arnaldojr/coracao_led/README.md

coracao_led
===========

desenvolvimento de um placa no formato de um coração rodeado de Led.

Microcontrolado por um pic18f452;
Acelerometro adxl345 para detecção de movimentos;
Conversor DC/DC step-Up 3v/5v para alimentação por pilha;
Saida serial para PC;
