arnaldojr/coracao_led/Lista de material e imagens/Documento1.pdf

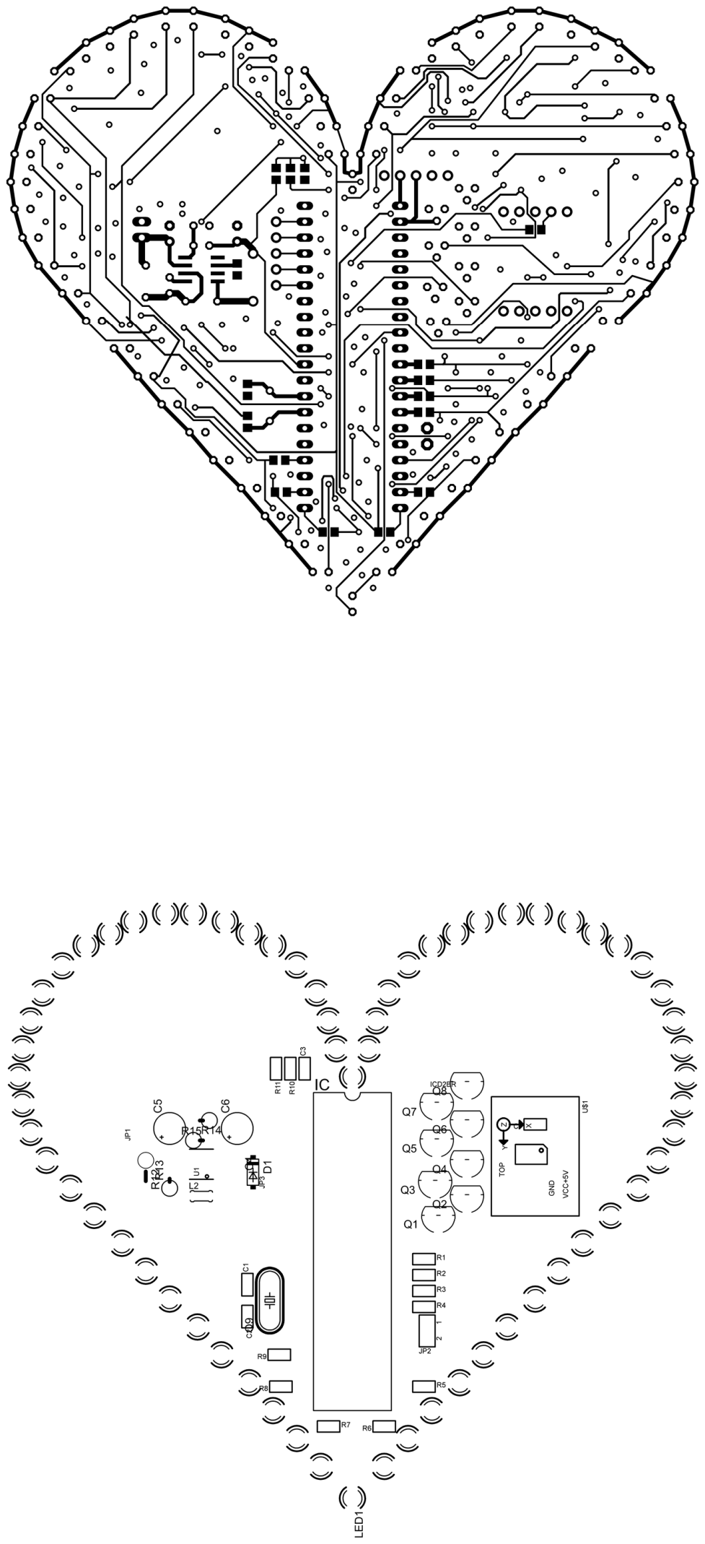
[picture p1: page 1]
