arnaldojr/coracao_led/Lista de material e imagens/Sem título.png

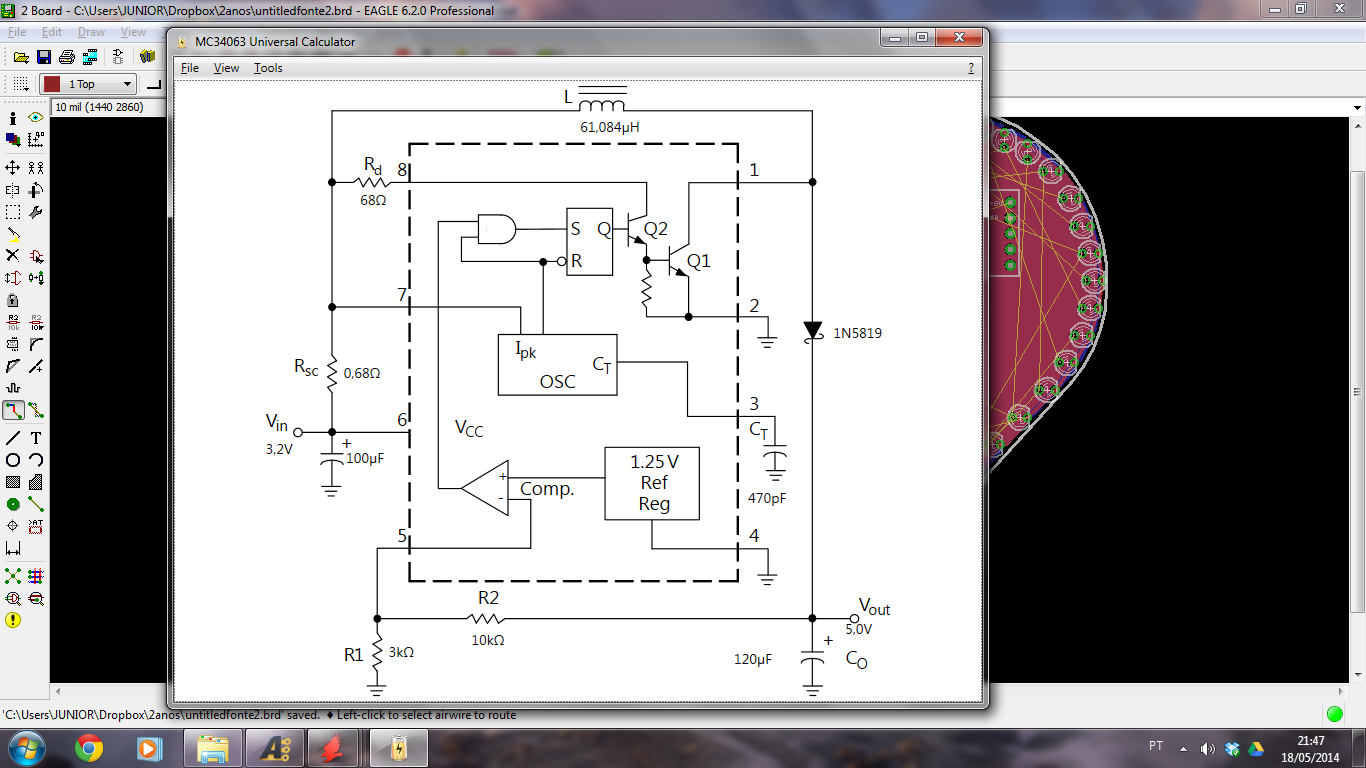
Lista de material e imagens/Sem título.png
