arnaldojr/coracao_led/Lista de material e imagens/untitledfonte2.pdf

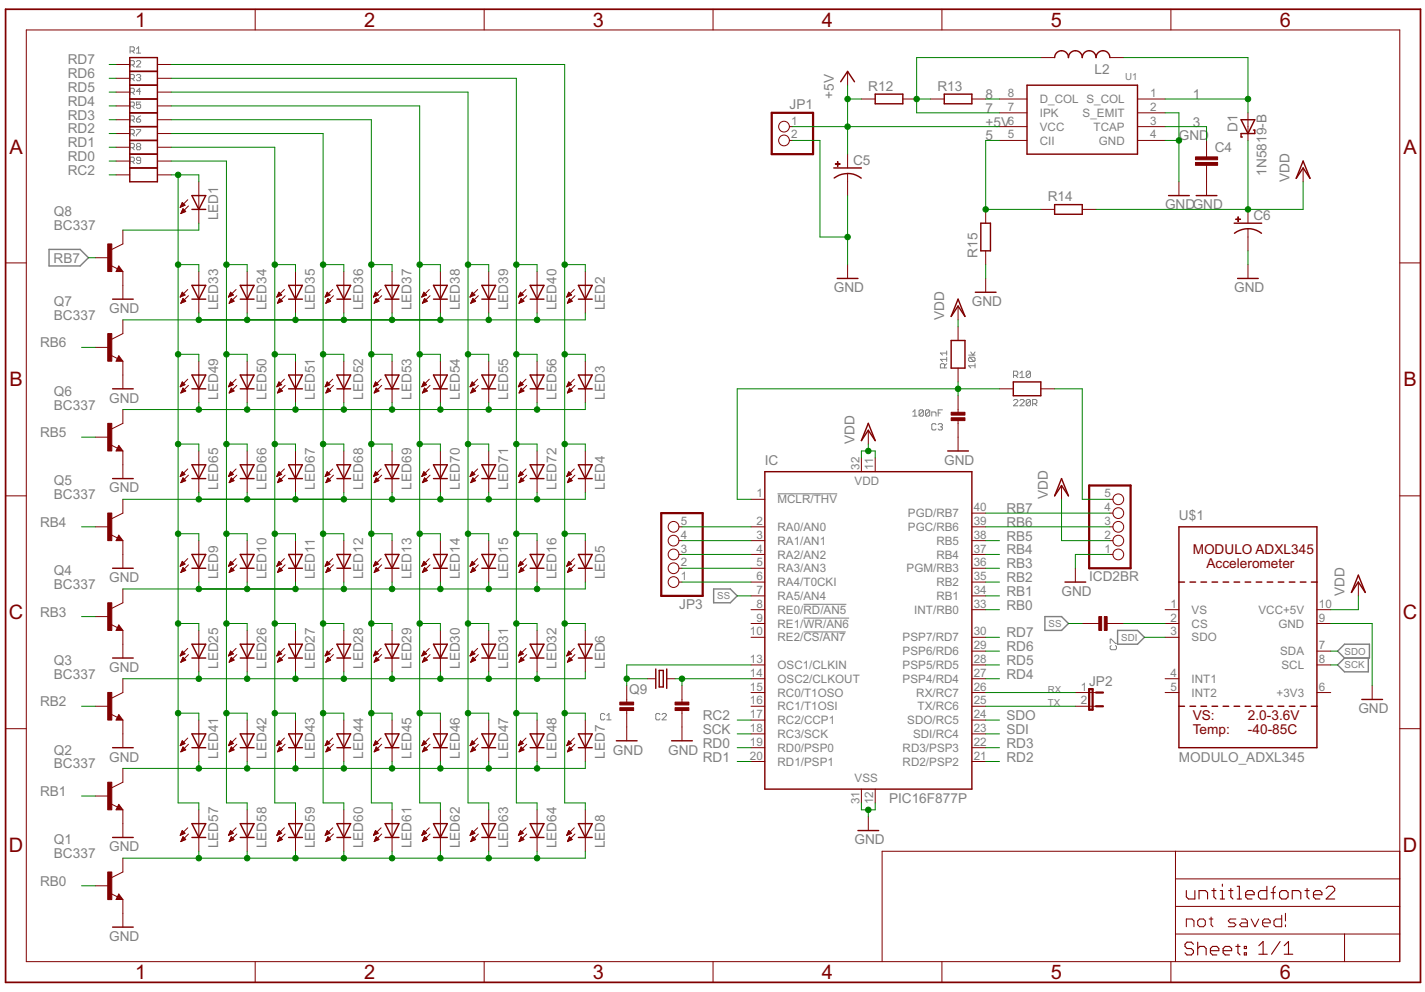
[picture p3: page 1]
