arnaldojr/coracao_led/Hardware/untitledfonte2.brd

## EAGLE design Hardware/untitledfonte2.brd (2014-07-24)

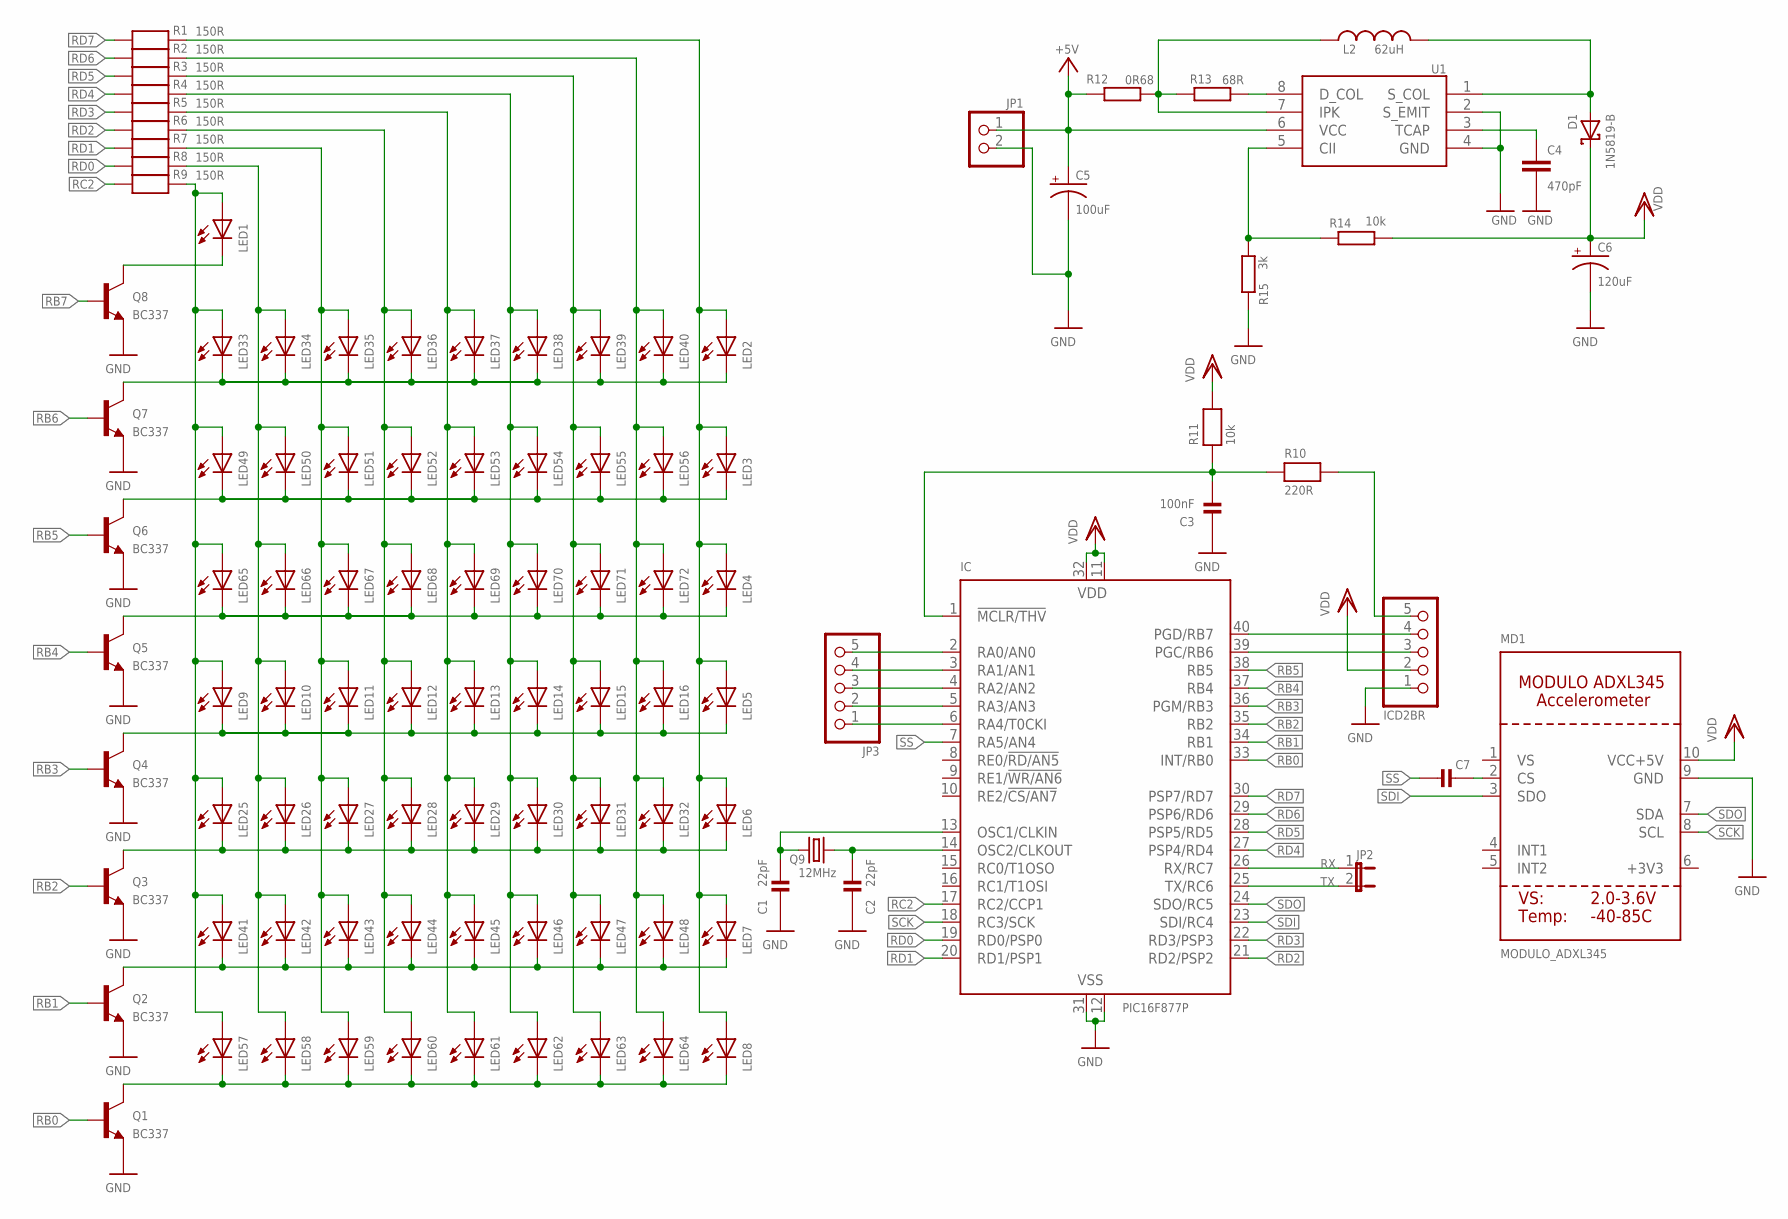
[picture p4: schematic untitledfonte2.sch]

Parts:
C1, C2: 22pF; 0805_NOTHERMALS
C3: 100nF; 0805_NOTHERMALS
C4: 470pF; C0805
C5: 100uF; E2,5-5
C6: 120uF; E2,5-5
C7: CAP_CERAMIC0805-NOTHERMALS; 0805_NOTHERMALS
D1: 1N5819-B; DO41-7.6
IC: PIC16F877P; DIL40
ICD2BR: HEADER-1X5ROUND; 1X05_ROUND
JP1: HEADER-1X2; 1X02_OVAL
JP2: JUMPER2
JP3: HEADER-1X5ROUND; 1X05_ROUND
L2: 62uH; 0204/5
LED1, LED2, LED3, LED4, LED5, LED6, LED7, LED8, LED9, LED10, LED11, LED12, LED13, LED14, LED15, LED16, LED25, LED26, LED27, LED28, LED29, LED30, LED31, LED32, LED33, LED34, LED35, LED36, LED37, LED38, LED39, LED40, LED41, LED42, LED43, LED44, LED45, LED46, LED47, LED48, LED49, LED50, LED51, LED52, LED53, LED54, LED55, LED56, LED57, LED58, LED59, LED60, LED61, LED62, LED63, LED64, LED65, LED66, LED67, LED68, LED69, LED70, LED71, LED72: LED3MM
MD1: MODULO_ADXL345
Q1, Q2, Q3, Q4, Q5, Q6, Q7, Q8: BC337; TO92
Q9: 12MHz; HC49/S
R1, R2, R3, R4, R5, R6, R7, R8, R9: 150R; 0805_NOTHERMALS
R10: 220R; 0805_NOTHERMALS
R11: 10k; 0805_NOTHERMALS
R12: 0R68; 0207/5V
R13: 68R; 0207/2V
R14: 10k; 0207/2V
R15: 3k; 0207/2V
U1: MC34063A; SOIC8_150MIL

Connections:
1: D1.A, L2.2, U1.1 (S_COL)
3: C4.1, U1.3 (TCAP)
5: R14.1, R15.2, U1.5 (CII)
7: L2.1, R12.2, R13.1, U1.7 (IPK)
8: R13.2, U1.8 (D_COL)
+5V: C5.+, JP1.1, R12.1, U1.6 (VCC)
GND: C1.1, C2.1, C3.1, C4.2, C5.-, C6.-, IC.12 (VSS), IC.31 (VSS), ICD2BR.1, JP1.2, MD1.9 (GND), Q1.1 (E), Q2.1 (E), Q3.1 (E), Q4.1 (E), Q5.1 (E), Q6.1 (E), Q7.1 (E), Q8.1 (E), R15.1, U1.2 (S_EMIT), U1.4 (GND)
unnamed: LED1.K (C), Q8.3 (C)
unnamed: C7.1, MD1.2 (CS)
unnamed: LED4.K (C), LED65.K (C), LED66.K (C), LED67.K (C), LED68.K (C), LED69.K (C), LED70.K (C), LED71.K (C), LED72.K (C), Q5.3 (C)
unnamed: LED3.K (C), LED49.K (C), LED50.K (C), LED51.K (C), LED52.K (C), LED53.K (C), LED54.K (C), LED55.K (C), LED56.K (C), Q6.3 (C)
unnamed: LED8.K (C), LED57.K (C), LED58.K (C), LED59.K (C), LED60.K (C), LED61.K (C), LED62.K (C), LED63.K (C), LED64.K (C), Q1.3 (C)
unnamed: LED7.K (C), LED41.K (C), LED42.K (C), LED43.K (C), LED44.K (C), LED45.K (C), LED46.K (C), LED47.K (C), LED48.K (C), Q2.3 (C)
unnamed: LED1.A, LED9.A, LED25.A, LED33.A, LED41.A, LED49.A, LED57.A, LED65.A, R9.2
unnamed: LED10.A, LED26.A, LED34.A, LED42.A, LED50.A, LED58.A, LED66.A, R8.2
unnamed: LED11.A, LED27.A, LED35.A, LED43.A, LED51.A, LED59.A, LED67.A, R7.2
unnamed: LED12.A, LED28.A, LED36.A, LED44.A, LED52.A, LED60.A, LED68.A, R6.2
unnamed: LED2.K (C), LED33.K (C), LED34.K (C), LED35.K (C), LED36.K (C), LED37.K (C), LED38.K (C), LED39.K (C), LED40.K (C), Q7.3 (C)
unnamed: LED13.A, LED29.A, LED37.A, LED45.A, LED53.A, LED61.A, LED69.A, R5.2
unnamed: LED14.A, LED30.A, LED38.A, LED46.A, LED54.A, LED62.A, LED70.A, R4.2
unnamed: LED5.K (C), LED9.K (C), LED10.K (C), LED11.K (C), LED12.K (C), LED13.K (C), LED14.K (C), LED15.K (C), LED16.K (C), Q4.3 (C)
unnamed: LED15.A, LED31.A, LED39.A, LED47.A, LED55.A, LED63.A, LED71.A, R3.2
unnamed: LED16.A, LED32.A, LED40.A, LED48.A, LED56.A, LED64.A, LED72.A, R2.2
unnamed: LED2.A, LED3.A, LED4.A, LED5.A, LED6.A, LED7.A, LED8.A, R1.2
unnamed: IC.2 (RA0/AN0), JP3.5
unnamed: IC.3 (RA1/AN1), JP3.4
unnamed: IC.4 (RA2/AN2), JP3.3
unnamed: IC.5 (RA3/AN3), JP3.2
unnamed: IC.6 (RA4/T0CKI), JP3.1
unnamed: LED6.K (C), LED25.K (C), LED26.K (C), LED27.K (C), LED28.K (C), LED29.K (C), LED30.K (C), LED31.K (C), LED32.K (C), Q3.3 (C)
unnamed: C1.2, IC.13 (OSC1/CLKIN), Q9.2
unnamed: C2.2, IC.14 (OSC2/CLKOUT), Q9.1
unnamed: ICD2BR.5, R10.2
unnamed: C3.2, IC.1 (!MCLR/THV), R10.1, R11.1
RB0: IC.33 (INT/RB0), Q1.2 (B)
RB1: IC.34 (RB1), Q2.2 (B)
RB2: IC.35 (RB2), Q3.2 (B)
RB3: IC.36 (PGM/RB3), Q4.2 (B)
RB4: IC.37 (RB4), Q5.2 (B)
RB5: IC.38 (RB5), Q6.2 (B)
RB6: IC.39 (PGC/RB6), ICD2BR.3, Q7.2 (B)
RB7: IC.40 (PGD/RB7), ICD2BR.4, Q8.2 (B)
RC2: IC.17 (RC2/CCP1), R9.1
RD0: IC.19 (RD0/PSP0), R8.1
RD1: IC.20 (RD1/PSP1), R7.1
RD2: IC.21 (RD2/PSP2), R6.1
RD3: IC.22 (RD3/PSP3), R5.1
RD4: IC.27 (PSP4/RD4), R4.1
RD5: IC.28 (PSP5/RD5), R3.1
RD6: IC.29 (PSP6/RD6), R2.1
RD7: IC.30 (PSP7/RD7), R1.1
RX: IC.26 (RX/RC7), JP2.1
SCK: IC.18 (RC3/SCK), MD1.8 (SCL)
SDI: IC.23 (SDI/RC4), MD1.3 (SDO)
SDO: IC.24 (SDO/RC5), MD1.7 (SDA)
SS: C7.2, IC.7 (RA5/AN4)
TX: IC.25 (TX/RC6), JP2.2
VDD: C6.+, D1.C, IC.11 (VDD), IC.32 (VDD), ICD2BR.2, MD1.10 (VCC+5V), R11.2, R14.2

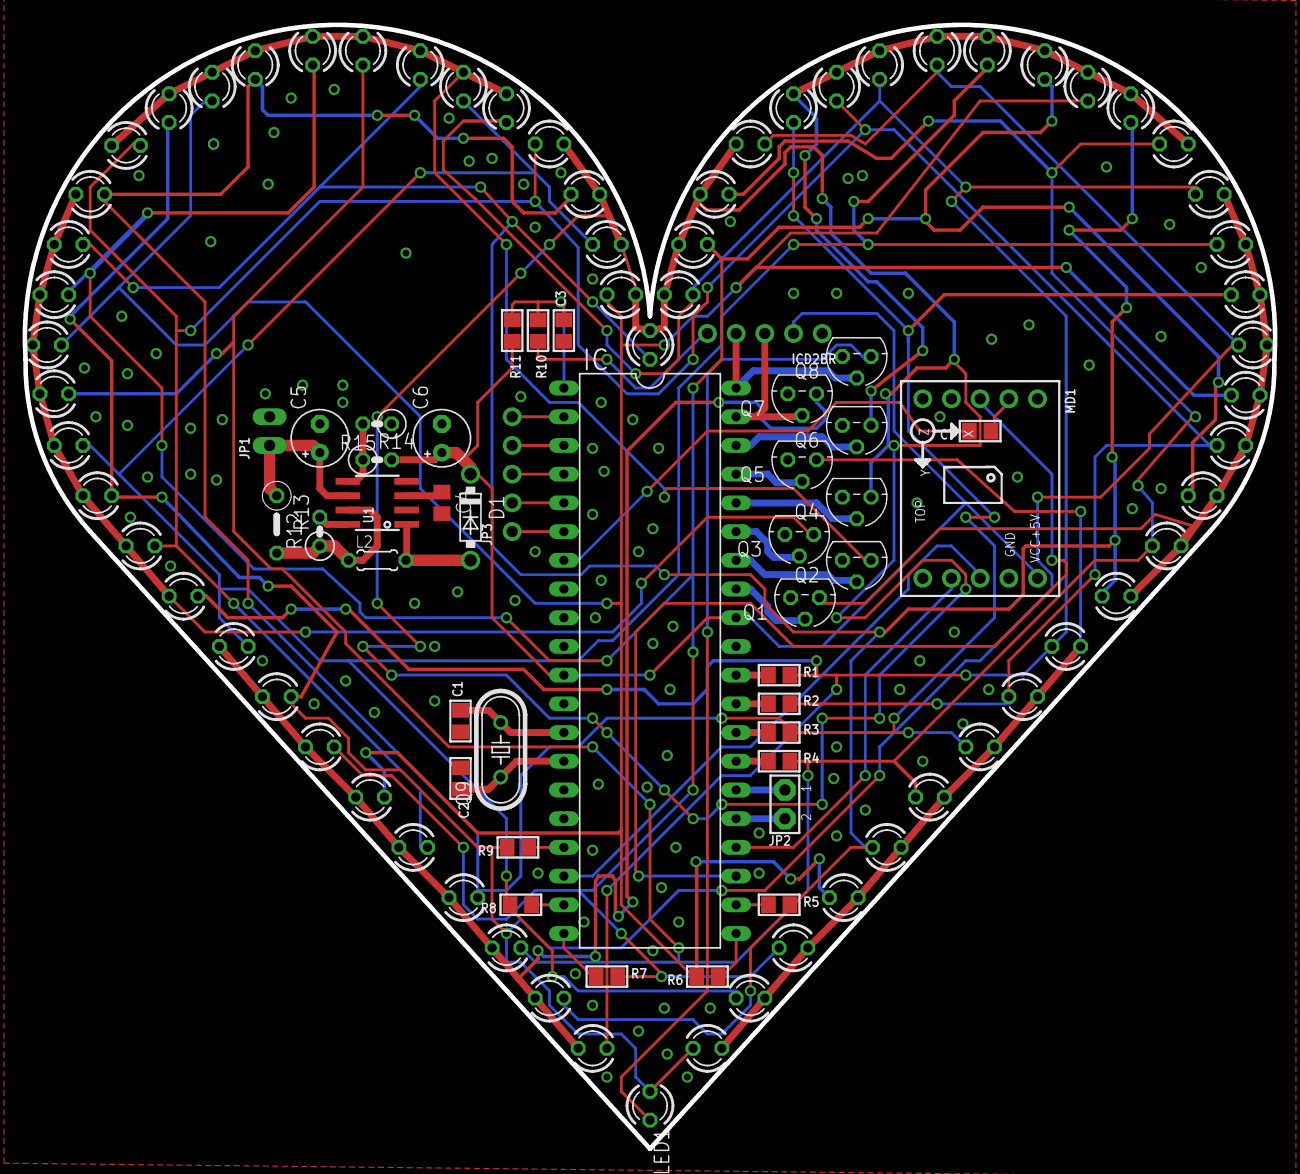
[picture p5: board untitledfonte2.brd from above]

Board: 2 copper layers, 110.6 x 99.4 mm, 104 parts (0 on the bottom side), 58 nets.
