arnaldojr/coracao_led/Sofware/main.c

/* Nome: main.c
 * Projeto: Coração LED
 * Autor: Arnaldo Jr
 * Data de Criação: 26/07/2014
 */

#include <p18f452.h>
#include <delays.h>
#include <stdlib.h>
#include "leds.h"

#pragma config WDT = OFF, LVP = OFF, OSC = XT, PWRT = ON, BOR = ON, BORV = 42

//PROTOTIPO DE FUNÇOES



void main()
{
 	//CONFIGURAÇAO DOS PORTS
	TRISA = 0x00; 		// RA0 ATÉ RA5 COMO SAIDA
	TRISB = 0x00;		// RB0 ATÉ RB7 COMO SAIDA ACIONA TRANSISTORES
	TRISC = 0b10000000; // RC7: Rx e RC6:Tx RC2-SAIDA LED
	TRISD = 0x00;		// RD0 ATÉ RD7 COMO SAIDA PARA OS LEDS 
	TRISE = 0x00;		// RE0 ATÉ RE2 COMO SAIDA
	

	while(1)
	{
/*		int i;
		for (i=0;i<N_LEDS;i++)	//giro no sentido anti-horario acende um por vez
		{
			acender_led(i,vled);
			Delay10KTCYx(250);		// 250ms
		}
		
		for (i=N_LEDS;i=0;i--)		//giro no sentido horario acende um por vez
			{
			acender_led(i,vled);
			Delay1KTCYx(250);		// 250ms
		}		
*/
		
/*		Delay1KTCYx(250);	//Delay  250 * 1000 * 1 = 250000 µs  = 0,25s = 250ms @ 4MHz
		if(PORTB==0b10000000)
		{
			PORTB=0b00000001;
			PORTD = PORTD<<1;
		}
		else PORTB = PORTB<< 1;
		
		if(PORTD==0b10000000)
		PORTD = 0b00000001;
			
*/	
PORTB=0b10000000; PORTD=0b00000000; PORTC=0b00000100; Delay10KTCYx(250);		//LED1
                                                      
PORTB=0b00010000; PORTD=0b00000000; PORTC=0b00000100; Delay10KTCYx(250);		//LED2
PORTB=0b00010000; PORTD=0b00000001; PORTC=0b00000000; Delay10KTCYx(250);		//LED3
PORTB=0b00010000; PORTD=0b00000010; PORTC=0b00000000; Delay10KTCYx(250);		//LED4
PORTB=0b00010000; PORTD=0b00000100; PORTC=0b00000000; Delay10KTCYx(250);		//LED5								
PORTB=0b00010000; PORTD=0b00001000; PORTC=0b00000000; Delay10KTCYx(250);		//LED6
PORTB=0b00010000; PORTD=0b00010000; PORTC=0b00000000; Delay10KTCYx(250);		//LED7
PORTB=0b00010000; PORTD=0b00100000; PORTC=0b00000000; Delay10KTCYx(250);		//LED8
PORTB=0b00010000; PORTD=0b01000000; PORTC=0b00000000; Delay10KTCYx(250);		//LED9									
PORTB=0b00010000; PORTD=0b10000000; PORTC=0b00000000; Delay10KTCYx(250);		//LED10 ok
                                                      
PORTB=0b00000001; PORTD=0b00001000; PORTC=0b00000000; Delay10KTCYx(250);		//LED11								
PORTB=0b00000001; PORTD=0b00010000; PORTC=0b00000000; Delay10KTCYx(250);		//LED12
PORTB=0b00000001; PORTD=0b00000001; PORTC=0b00000000; Delay10KTCYx(250);		//LED13
PORTB=0b00000001; PORTD=0b01000000; PORTC=0b00000000; Delay10KTCYx(250);		//LED14
PORTB=0b00000001; PORTD=0b00000100; PORTC=0b00000000; Delay10KTCYx(250);		//LED15
PORTB=0b00000001; PORTD=0b00000000; PORTC=0b00000100; Delay10KTCYx(250);		//LED16
PORTB=0b00000001; PORTD=0b00100000; PORTC=0b00000000; Delay10KTCYx(250);		//LED17									
PORTB=0b00000001; PORTD=0b00000001; PORTC=0b00000000; Delay10KTCYx(250);		//LED18
PORTB=0b00000001; PORTD=0b10000000; PORTC=0b00000000; Delay10KTCYx(250);		//LED19 ok
                                                      
PORTB=0b00100000; PORTD=0b00010000; PORTC=0b00000000; Delay10KTCYx(250);		//LED20
PORTB=0b00100000; PORTD=0b00001000; PORTC=0b00000000; Delay10KTCYx(250);		//LED21
PORTB=0b00100000; PORTD=0b00000100; PORTC=0b00000000; Delay10KTCYx(250);		//LED22
PORTB=0b00100000; PORTD=0b00000010; PORTC=0b00000000; Delay10KTCYx(250);		//LED23								
PORTB=0b00100000; PORTD=0b00000001; PORTC=0b00000000; Delay10KTCYx(250);		//LED24
PORTB=0b00100000; PORTD=0b00000000; PORTC=0b00000100; Delay10KTCYx(250);		//LED25									
PORTB=0b00100000; PORTD=0b10000000; PORTC=0b00000000; Delay10KTCYx(250);		//LED26
PORTB=0b00100000; PORTD=0b01000000; PORTC=0b00000000; Delay10KTCYx(250);		//LED27
PORTB=0b00100000; PORTD=0b00100000; PORTC=0b00000000; Delay10KTCYx(250);		//LED28 ok
                                                      
PORTB=0b00001000; PORTD=0b00000000; PORTC=0b00000000; Delay10KTCYx(250);		//LED29							
PORTB=0b00001000; PORTD=0b00010000; PORTC=0b00000000; Delay10KTCYx(250);		//LED30
PORTB=0b00001000; PORTD=0b00000010; PORTC=0b00000000; Delay10KTCYx(250);		//LED31
PORTB=0b00001000; PORTD=0b10000000; PORTC=0b00000000; Delay10KTCYx(250);		//LED32
PORTB=0b00001000; PORTD=0b00001000; PORTC=0b00000000; Delay10KTCYx(250);		//LED33									
PORTB=0b00001000; PORTD=0b00000100; PORTC=0b00000000; Delay10KTCYx(250);		//LED34
PORTB=0b00001000; PORTD=0b00000001; PORTC=0b00000000; Delay10KTCYx(250);		//LED35								
PORTB=0b00001000; PORTD=0b00100000; PORTC=0b00000000; Delay10KTCYx(250);		//LED36
PORTB=0b00001000; PORTD=0b01000000; PORTC=0b00000000; Delay10KTCYx(250);		//LED37 ok
                                                      
PORTB=0b00000010; PORTD=0b10000000; PORTC=0b00000100; Delay10KTCYx(250);		//LED38
PORTB=0b00000010; PORTD=0b00000001; PORTC=0b00000000; Delay10KTCYx(250);		//LED39
PORTB=0b00000010; PORTD=0b00001000; PORTC=0b00000000; Delay10KTCYx(250);		//LED40
PORTB=0b00000010; PORTD=0b00010000; PORTC=0b00000000; Delay10KTCYx(250);		//LED41									
PORTB=0b00000010; PORTD=0b00000010; PORTC=0b00000000; Delay10KTCYx(250);		//LED42
PORTB=0b00000010; PORTD=0b00100000; PORTC=0b00000000; Delay10KTCYx(250);		//LED43
PORTB=0b00000010; PORTD=0b00000100; PORTC=0b00000000; Delay10KTCYx(250);		//LED44
PORTB=0b00000010; PORTD=0b00000000; PORTC=0b00000100; Delay10KTCYx(250);		//LED45
PORTB=0b00000010; PORTD=0b01000000; PORTC=0b00000000; Delay10KTCYx(250);		//LED46 ok
                                                      
PORTB=0b00000100; PORTD=0b00100000; PORTC=0b00000000; Delay10KTCYx(250);		//LED47								
PORTB=0b00000100; PORTD=0b00001000; PORTC=0b00000000; Delay10KTCYx(250);		//LED48
PORTB=0b00000100; PORTD=0b00000010; PORTC=0b00000000; Delay10KTCYx(250);		//LED49									
PORTB=0b00000100; PORTD=0b00000100; PORTC=0b00000000; Delay10KTCYx(250);		//LED50
PORTB=0b00000100; PORTD=0b00010000; PORTC=0b00000000; Delay10KTCYx(250);		//LED51
PORTB=0b00000100; PORTD=0b00000001; PORTC=0b00000000; Delay10KTCYx(250);		//LED52
PORTB=0b00000100; PORTD=0b00000000; PORTC=0b00000100; Delay10KTCYx(250);		//LED53								
PORTB=0b00000100; PORTD=0b01000000; PORTC=0b00000000; Delay10KTCYx(250);		//LED54
PORTB=0b00000100; PORTD=0b10000000; PORTC=0b00000000; Delay10KTCYx(250);		//LED55 ok
                                                      
PORTB=0b01000000; PORTD=0b00000001; PORTC=0b00000000; Delay10KTCYx(250);		//LED56
PORTB=0b01000000; PORTD=0b00000000; PORTC=0b00000100; Delay10KTCYx(250);		//LED57									
PORTB=0b01000000; PORTD=0b00000010; PORTC=0b00000000; Delay10KTCYx(250);		//LED58
PORTB=0b01000000; PORTD=0b00000100; PORTC=0b00000000; Delay10KTCYx(250);		//LED59								
PORTB=0b01000000; PORTD=0b01000000; PORTC=0b00000000; Delay10KTCYx(250);		//LED60
PORTB=0b01000000; PORTD=0b00100000; PORTC=0b00000000; Delay10KTCYx(250);		//LED61
PORTB=0b01000000; PORTD=0b00010000; PORTC=0b00000000; Delay10KTCYx(250);		//LED62
PORTB=0b01000000; PORTD=0b00001000; PORTC=0b00000000; Delay10KTCYx(250);		//LED63
PORTB=0b01000000; PORTD=0b10000000; PORTC=0b00000000; Delay10KTCYx(250);		//LED64 ok
				
				
				
	}
}
