arnaldojr/coracao_led/Sofware/leds.c

#include "leds.h"

void acender_led(int numero_led, int vetor_leds[N_LEDS][N_COLUNAS]){
	PORTB=vetor_leds[numero_led][P_B];
	PORTD=vetor_leds[numero_led][P_D];
	PORTC=vetor_leds[numero_led][P_C];
}

const rom int vled[N_LEDS][N_COLUNAS] = {
									{0b10000000,0b00000000,0b00000100},		//LED1
									
									{0b00010000,0b00000000,0b00000100},		//LED2
									{0b00010000,0b00000001,0b00000000},		//LED3
									{0b00010000,0b00000010,0b00000000},		//LED4
									{0b00010000,0b00000100,0b00000000},		//LED5								
									{0b00010000,0b00001000,0b00000000},		//LED6
									{0b00010000,0b00010000,0b00000000},		//LED7
									{0b00010000,0b00100000,0b00000000},		//LED8
									{0b00010000,0b01000000,0b00000000},		//LED9									
									{0b00010000,0b10000000,0b00000000},		//LED10 ok
									
									{0b00000001,0b00001000,0b00000000},		//LED11								
									{0b00000001,0b00010000,0b00000000},		//LED12
									{0b00000001,0b00000001,0b00000000},		//LED13
									{0b00000001,0b01000000,0b00000000},		//LED14
									{0b00000001,0b00000100,0b00000000},		//LED15
									{0b00000001,0b00000000,0b00000100},		//LED16
									{0b00000001,0b00100000,0b00000000},		//LED17									
									{0b00000001,0b00000001,0b00000000},		//LED18
									{0b00000001,0b10000000,0b00000000},		//LED19 ok
									
									{0b00100000,0b00010000,0b00000000},		//LED20
									{0b00100000,0b00001000,0b00000000},		//LED21
									{0b00100000,0b00000100,0b00000000},		//LED22
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
vetor_leds[9][P_D]=0b10000000;
vetor_leds[9][P_C]=0b00000000;

//LED 10
vetor_leds[10][P_B]=0b00000001;
vetor_leds[10][P_D]=0b00001000;
vetor_leds[10][P_C]=0b00000000;

//LED 11
vetor_leds[11][P_B]=0b00000001;
vetor_leds[11][P_D]=0b00010000;
vetor_leds[11][P_C]=0b00000000;
}
*/
