arnaldojr/coracao_led/(commit log)

2014-07-24 Placa PCI
    Projeto desenvolvido no Eagle 6.2.
    [untitledfonte2.brd, untitledfonte2.sch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]
2014-07-24 atualização da pasta
    [untitledfonte2.brd, untitledfonte2.sch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]
2014-07-24 Outros
    lista de materiais, imagens.
    [untitledfonte2.csv, untitledfonte2.xls]
2014-07-26 mapeamento dos leds
    todos os led estão mapeados no sentido anti-horario
2014-07-27 acende um por vez
    acende todos leds no sentido anti-horario, depois no sentido horario.
2014-07-30 Pisca pisca
    com problema na placa led5,led12, led13
    [main.c]
2014-07-30 PISCA PISCA
    mapeado todos os leds para acender na seguencia um por vez no sentido
    horario..
